joric/nrfmicro/README.md

# nRFMicro

* Project wiki: https://github.com/joric/nrfmicro/wiki
* Latest gerbers: [nrfmicro-main-gerbers.zip](../../releases/latest/download/nrfmicro-main-gerbers.zip)
* iBOM: https://joric.github.io/nrfmicro/
* Note kikit-1.0.0 I use is not compatible with newest Kicad 7. Use [Kicad 6.0.11](https://s3.cern.ch/kicad-downloads/windows/stable/kicad-6.0.11-x86_64.exe) for pull requests.

front|back
--|--
front|back
