joric/nrfmicro/(threads)

Thread 3 (2019-07-09):

Cheaper USB-C connector

BenRoe, 2019-07-09:
Hi,
i followed you project for a while. Right now i collect all the parts.
I already have the pcb's.
I found a cheaper alternative to [your connector](https://lcsc.com/product-detail/USB-Type-C_MC-311D_C136423.html) in the part list.
https://lcsc.com/product-detail/USB-Type-C_Korean-Hroparts-Elec-TYPE-C-31-M-12_C165948.html
I have these connectors here and they fit on the pcb. Connectors too.

joric, 2019-07-09:
I DID point LCSC part to C136423, read my BOM more carefully. Closing.

Closed 2019-07-09.

Thread 4 (2019-07-29):

Capacitors for XTAL

PJE66, 2019-07-29:
Love, Love, Love, Love the project - I'm going to borrow some of the design to integrate into my one hand keyboard which currently uses an ATSAMD21.

Just wondering whether there needs to be two small capacitors (22pF) added to the XTAL to match what Adafruit did.

joric, 2019-07-30:
@PJE66 I was under impression you can skip them and solder the 2-leg resonator (NOT oscillator, oscillator is an active thing with 3-4 legs). They are for the slight frequency correction at inrush and low current. I'm not using external resonator at all, but sometimes it needed if you can't recompile the firmware to use internal RC.  See https://devzone.nordicsemi.com/f/nordic-q-a/40627/zigbee-coordinator-production-configuration-missing-or-invalid/158061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 It works if you solder it directly without those load capacitors.

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

Closed 2019-07-30.

Thread 6 (2019-09-16):

Problem to unlock the nrf chip with Blackmagic

BenRoe, 2019-09-16:
I try to unlock the nrf chip on Linux Debian.
Port is correct (ttyACM0 and ttyACM1 are available).
Wirering should be correct (see picture).
Any idea what the problem could be?

I can't figure out what the problem is.

```bash
arm-none-eabi-gdb --batch -ex "target extended-remote /dev/ttyACM0" -ex "mon swdp_scan" -ex "att 2" -ex "mon erase_mass"
Target voltage: unknown
Available Targets:
No. Att Driver
 1      Nordic nRF52 Access Port
Attaching to Remote target failed
Target does not support this command.
```
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

I also get only one available target in gdb.
```bash
pi@raspberrypi:~/Downloads $ arm-none-eabi-gdb
GNU gdb (7.10-1+9) 7.10
Copyright (C) 2015 Free Software Foundation, Inc.
License GPLv3+: GNU GPL version 3 or later <http://gnu.org/licenses/gpl.html>
This is free software: you are free to change and redistribute it.
There is NO WARRANTY, to the extent permitted by law.  Type "show copying"
and "show warranty" for details.
This GDB was configured as "--host=arm-linux-gnueabihf --target=arm-none-eabi".
Type "show configuration" for configuration details.
For bug reporting instructions, please see:
<http://www.gnu.org/software/gdb/bugs/>.
Find the GDB manual and other documentation resources online at:
<http://www.gnu.org/software/gdb/documentation/>.
For help, type "help".
Type "apropos word" to search for commands related to "word".
(gdb) target extended-remote /dev/ttyACM0
Remote debugging using /dev/ttyACM0
(gdb) set non-stop on
(gdb) mon swdp_scan
Target voltage: unknown
Available Targets:
No. Att Driver
 1      Nordic nRF52 Access Port
(gdb)
```

Lenbok, 2019-09-17:
@BenRoe Cool to see someone else making these.

Before the module is unlocked there is only one target available (the `Nordic nRF52 Access Port` that you see) and that is the one you need to attach to and do the `mon erase` on.

After that, when you connect or do the next `swdp_scan`, you should see two targets available. On my box (old PC hardware running Ubuntu 18.04), I found it a bit troublesome, in that the unlock would kill my USB port.

Here are a couple of pastes from the logs I've been keeping as I go...

Side note: I set up some udev rules so the black magic probe always gets the same name:

```bash
cat <<EOF | sudo tee -a /etc/udev/rules.d/99-blackmagic.rules
# Black Magic Probe
# there are two connections, one for GDB and one for uart debugging
  SUBSYSTEM=="tty", ATTRS{interface}=="Black Magic GDB Server", SYMLINK+="ttyBmpGdb"
  SUBSYSTEM=="tty", ATTRS{interface}=="Black Magic UART Port", SYMLINK+="ttyBmpTarg"
EOF
sudo service udev restart
```
That lets me use `/dev/ttyBmpGdb` with gdb.

On to the unlocking:
```bash
$ arm-none-eabi-gdb --ex "target extended-remote /dev/ttyBmpGdb" --ex "mon swdp_scan"
GNU gdb (GNU Tools for Arm Embedded Processors 7-2018-q3-update) 8.1.0.20180315-git
Copyright (C) 2018 Free Software Foundation, Inc.
License GPLv3+: GNU GPL version 3 or later <http://gnu.org/licenses/gpl.html>
This is free software: you are free to change and redistribute it.
There is NO WARRANTY, to the extent permitted by law.  Type "show copying"
and "show warranty" for details.
This GDB was configured as "--host=x86_64-pc-linux-gnu --target=arm-none-eabi".
Type "show configuration" for configuration details.
For bug reporting instructions, please see:
<http://www.gnu.org/software/gdb/bugs/>.
Find the GDB manual and other documentation resources online at:
<http://www.gnu.org/software/gdb/documentation/>.
For help, type "help".
Type "apropos word" to search for commands related to "word".
Remote debugging using /dev/ttyBmpGdb
Target voltage: unknown
Available Targets:
No. Att Driver
 1      Nordic nRF52 Access Port
(gdb) att 1
Attaching to Remote target
warning: while parsing target description: no element found
warning: Could not load XML target description; ignoring
PC register is not available
(gdb) mon erase_mass
(gdb) detach
Detaching from program: , Remote target
(gdb) quit
```
at which point I had to reboot, then:

```bash
$ arm-none-eabi-gdb --ex "target extended-remote /dev/ttyBmpGdb" --ex "mon swdp_scan"
[...]
Target voltage: unknown
Available Targets:
No. Att Driver
 1      Nordic nRF52 M3/M4
 2      Nordic nRF52 Access Port
(gdb) att 1
Attaching to Remote target
warning: No executable has been specified and target does not support
determining executable automatically.  Try using the "file" command.
0xfffffffe in ?? ()
(gdb) mon erase_mass
erase..
(gdb) load pca10056_bootloader-0.2.11_s140_6.1.1.hex
Loading section .sec1, size 0xb00 lma 0x0
Loading section .sec2, size 0xf000 lma 0x1000
Loading section .sec3, size 0x10000 lma 0x10000
Loading section .sec4, size 0x5de8 lma 0x20000
Loading section .sec5, size 0x70c8 lma 0xf4000
Loading section .sec6, size 0x8 lma 0x10001014
Start address 0x0, load size 182712
Transfer rate: 31 KB/sec, 966 bytes/write.
(gdb) detach
Detaching from program: , Remote target
(gdb) quit
$
```

Then power off BMP; power on BMP; power on USB to nrfmicro; mount the drive that appears. (Note that this was unlocking and flashing the raw module before connecting to the nrfmicro PCB, so I needed the BMP powered on to supply 3.3v to the module -- since yours is assembled you should just be able to connect it directly to the USB).

Now you can copy the precompiled test firmware to check each GPIO can flash a test LED as described on the wiki:

```bash
$ cp blink.uf2 /media/len/NRF52BOOT/
```
After the file copies, the volume will disappear, and the blink code is running, you can then proceed to verifying the pins on the nrfmicro. In all of the ones I soldered I had to wick some more solder to some of the inner pads to get the LED flashing, it's a neat design trick that @joric used there!

I've got my nrfmicros working with the test master/slave keyboard firmware on a corne, and am currently (when I can grab bits of time) updating to get the keymap I normally use working.

joric, 2019-09-17:
Great to see someone else experiences problems with my project! Also take a look at that https://github.com/AndruPol/nrf52832-recover/issues/1 (link from References in the [Software](https://github.com/joric/nrfmicro/wiki/Software) article).

Closed 2019-10-20.

Thread 8 (2019-10-25):

Make 104 keyboard firmware

624245305, 2019-10-25:
Make 104 keyboard firmware, add PIN pin under custom_board.h and pin_assign.h file, make firmware, add some pins and no response.

NRF52 does not have a CAPS/NUM LED pair?

joric, 2019-10-25:
I'm not supposed to decode this.

joric, 2019-10-25:
Assuming that "104" means you're making a 104-key keyboard using my controller, you won't have enough broken out pins. You can solder your own though.
Assuming "CAPS/NUM LED pair" is about indicator leds (there are usually three of those), I'm really not sure, it may be lost somewhere in the nrf52 fork it could need reading through the code. I haven't really used those.

Lenbok, 2019-10-25:
I think you are right about the nrf52 fork losing caps/num indicator support, as it didn't work for me when I tried displaying those led status on the crkbd OLED a few days ago.

Closed 2019-10-25.

Thread 9 (2019-10-29):

Consider to add more firmware information for alternative boards

kllp, 2019-10-29:
To me it's not clear if the nrf52 branch works for the following boards:
Adafruit Feather nRF52840 Express
Particle.io Xenon
Arduino Nano 33 BLE
STM32WB55

How much work is needed for each of them?
If you know please add a note to the wiki page. Thank you!
https://github.com/joric/nrfmicro/wiki/Alternatives#adafruit-feather-nrf52840-express

joric, 2019-10-29:
I have no idea really. That would require buying every board in the list.

Closed 2019-10-29.

Thread 10 (2019-11-12):

Where would I connect a LiPo battery?

skybound, 2019-11-12:
Thank you very much for this.  I ordered some PCBs myself, they should arrive within a few weeks.

I see there's a LiPo charger, but it doesn't look like VBAT is broken out to a pin.  How would I connect a battery?

joric, 2019-11-12:
[https://github.com/joric/nrfmicro/wiki/Hardware](Li-Po battery uses RAW and GND pins)

skybound, 2019-11-12:
I missed that section. Thank you.

Closed 2019-11-12.

Thread 11 (2019-11-13):

Battery life with coin battery?

Na-Cly, 2019-11-13:
Hey just wondering what kind of battery life you see with the coin cell battery. Do you know what it should be for a fully wireless split keyboard
Thanks.

joric, 2019-11-13:
I'd rather use 130 mAh 501230 lipo batteries they fit under promicro. Battery life could vary from 1-2 weeks to a few months but it doesn't really matter because batteries are rechargeable.

Lenbok, 2019-11-13:
Nice to see that battery recommendation. I am using these https://www.aliexpress.com/item/32981806740.html (they are quite long).

I don't currently have a battery estimate (I'm still trying to find out why I can't pair with my linux box, when it pairs to MacOS and Android just fine, could be my BT dongle), but a couple of things I've noted so far:

* With the current firmware the blue nrfmicro LED is illuminated essentially all the time, so we probably need to switch that off in software for battery conservation.
* I'm not sure how to monitor battery voltage on the slave side (for the master side there is a binding to echo it out as a string of keypresses, and I've also got it displaying on the oled, but I only have one oled connected)

Closed 2019-11-13.

Thread 12 (2019-11-13):

Licensing

Na-Cly, 2019-11-13:
Hey I see your pcb uses the Unlicense, but do you know if there's any restrictions when building this in regards to reselling? I'm planning on making a small batch and wanted to know if there was anything you knew of that would restrict resale.

joric, 2019-11-13:
It should be fine. Adafruit bootloader is MIT licensed so it should be ok to sell preflashed devices as well. But don't take my word for it, do your own research, I can't really help for that matter.

Closed 2019-11-13.

Thread 13 (2019-12-08):

coin cell battery vs lipo

fi0, 2019-12-08:
If I use a coin cell battery like CR2032 (not rechargeable) instead of lipo, how should I correctly connect it to the board? Thank you!

joric, 2019-12-08:
I haven't really though that through ) Better buy a lipo cell or a chargeable LIR2032 they're cheap. You can connect it to RAW/GND but there are no solder jumpers to disconnect it from the charger. I think you can just desolder MCP73831 that feeds 4.2V to the battery so the battery won't explode and you will be good.

fi0, 2019-12-08:
Thank you @joric, I'll go with your first advice :)

Closed 2019-12-08.

Thread 14 (2019-12-16):

Reciever option

haywirephoenix, 2019-12-16:
Would it be straight forward to switch to proprietary 2.4ghz + receiver approach? Pros would be increased battery life, lower latency, using keyboard in bios and usb wake from sleep.

joric, 2019-12-16:
This is not planned, I don't like receivers.

haywirephoenix, 2019-12-16:
It seems to be the choice for companies like Razer, Logitech, Microsoft, Kensington. There must be a reason for that. Can I ask why you don't like them? My question was if it was possible with some changes to the firmware.

I'm new to this, recently ordered everything for Nrfmicro and looking forward to the build. Thanks for your work on this btw!

joric, 2019-12-16:
I use exclusively laptops since about 2006 and I don't have much USB ports but there's always bluetooth , so receivers are not my jam. I made https://github.com/joric/bluetosis specially to get rid of receivers and I'm not planning to bring them back.

Closed 2019-12-16.

Thread 15 (2020-01-01):

Question about jumpers

Na-Cly, 2020-01-01:
Hey I noticed there's a few jumper pads. I can't seem to find on the wiki where it talks about what they are used for.

Thanks in advance.

joric, 2020-01-01:
Promicros on corne are usually flipped, if you got corne with hotswap sockets you can use those jumpers to keep antenna up. top 4 rows of pins can be flipped by those jumpers, bottom 8 rows of pins could be just remapped, as here (build with CFLAGS += -DFLIPPED_NRFMICRO):
https://github.com/joric/qmk/blob/nrf52-jorne/keyboards/jorne_ble/board/custom_board.h

Closed 2020-01-01.

Thread 16 (2020-01-21):

Pull USB-C pads farther down for handsoldering

skorokithakis, 2020-01-21:
This board is great, but handsoldering the USB-C module is rather harder than it should be because the pads are sitting flush with the connector pins. If you pull the pads a bit farther down, there will be enough space to handsolder comfortably.

I only managed to do it when I cut the top throughholes a bit and pushed the connector higher up to give it some space.

joric, 2020-01-21:
Yeah I'll account for it. The whole USB-C footprint needs rethinking because the front of the connector sits flush the pcb, it should be out for about 1mm. Haven't had so many problems with soldering though, just used more flux :)

Closed 2020-01-21.

Thread 17 (2020-01-25):

Led polarity

Na-Cly, 2020-01-25:
Is there an easy way to tell which way the LEDs lay for polarity? Its hard to tell from the picture, but I notice on the bottom I see a shape that looks like you can determine cathode from anonde.

joric, 2020-01-25:
what the hell. it's a square bracket on the pcb and a green stripe on the led. it's a STANDARD smd led footprint nobody redraws that from scratch

Na-Cly, 2020-01-25:
Never used smd LEDs this small and the hardware page shows the led already soldered. Thanks for getting back to me so quickly.

Closed 2020-01-25.

Thread 18 (2020-02-09):

The reset button to boot to the UF2 Mass Storage device.

luantty2, 2020-02-09:
Hi, I'm trying the nrfmicro but I noticed that there isn't a reset button on board, which might be needed in this process:
>After flashing the bootloader press reset button twice within 500ms interval to boot to the UF2 Mass Storage device. You have to convert standard .hex firmware to the UF2 format, using uf2conv.py.

Is that mean I need to create a button on my keyboard PCB? If it does,  which pins should  I connect to the button? Is that *GND* and *RESET* pin(P0.18)?
Also, in file *custom_board.h*,  it says:
```
#define RESET_PIN GPIO(1,18)
```
I found that the reset pin of nrf52840 should be P0.18, does this matter?

joric, 2020-02-09:
Keyboards usually have reset buttons connected to the promicro reset pin. To reset the keyboard programmatically see https://github.com/joric/qmk/blob/nrf52-jian/keyboards/jian_ble/keymaps/default/keymap.c#L141 (it's a little bit complicated).

joric, 2020-02-09:
Regarding 1.18 yeah I guess it's a typo, should be 0.18. But it's not used anywhere, probably it can be remapped from reset to something else but I'm not really sure. It's connected to the promicro reset pin.

vexchow, 2020-05-07:
Hi Joric,
Same question here.
I load the pca10056_bootloader-0.2.11_s140_6.1.1.hex or nrf51822_xxac.hex or s130_nrf51_2hex.
And then connect reset and GND, But nothing happens.
[https://imgur.com/a/fniLNi7](url)

I spend 3 days to try, can you please give some suggestion?
Thanks a lot.

joric, 2020-05-07:
it's double reset. also check solder jumpers.

Closed 2020-05-09.

Thread 20 (2020-03-02):

Group Buy Plans

NellyWhadsDev, 2020-03-02:
Heyo,

Wondering if you have any plans to run a group buy for this any time soon. Also, the build log is awesome - do you have something similar for ideas/planned changes/what still needs to be done (even if just for personal satisfaction)?

Awesome work; hoping to have these driving my first crkbd and/or ergodash boards.

joric, 2020-03-02:
None. No plans. Regarding ideas, see midmount and devel branches, PCBs are yet untested (still waiting for them, turnarounds are like 2 months considering sourcing all the components and sometimes it gets lost in transit). I got rid of voltage regulator, there's an internal one, added power mosfet and a better battery divider (800K/2M) to minimize leaks but it costed a physical switch and reversability in favor of ultra low profile (~2.5mm if you remove shielding).

Closed 2020-03-02.

Thread 21 (2020-03-29):

Lipo battery not charging

luantty2, 2020-03-29:
The voltage of battery does not change after charging for 1 hour, my multimeter always says the voltage of battery is 3.90V, is there any way to detect if the battery charging circuit is working?
And I noticed that the voltage of my 'VBUS' is 5.16V, which is a little bit higher than the protection circuit on the battery(they specified 4.2V-5V), could this be the problem of preventing the battery from charging?

joric, 2020-03-29:
Charging voltage is always 4.2V, VBUS is always 5V. Battery should charge no matter what, if the voltage is right.

luantty2, 2020-03-29:
Okay, it's charging now, caused by my bad soldering, thanks.

Closed 2020-03-29.

Thread 23 (2020-04-27):

Issue: Flashing Bootloader for Holyiot nrf52840

marhalloweenvt, 2020-04-27:
Hello joric,

I have followed your work for a while and they are really amazing.
Recently, i decided to design a board using nrf52840. So i bought some Holyiot nrf52840 module from China and followed your schematic. Currently, i am using stlink-v2 and Msys32 to flash this module. I can't unlock nor flash bootloader for this module. Please have look at below log for flashing bootloader:

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

And when i tried to unlock this module, it gives me this mess:

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

Could you please give me some advice what I should do?

Thank you,

joric, 2020-04-27:
I've been told openocd just works without unlocking. Haven't really tried. The command was openocd -f interface/stlink.cfg -f target/nrf52.cfg -c "gdb_flash_program enable" -c "gdb_breakpoint_override hard" -c "init" -c "reset halt" -c "flash write_image erase ./adafruitnrf52.hex" hope that helps.

Closed 2020-04-27.

Thread 24 (2020-05-14):

Parts list for v1.2

tlrogers-lap, 2020-05-14:
Joric, I just purchased 4 v1.2 alpha boards and am interested in building them. It does not look like the parts list BOM here [https://github.com/joric/nrfmicro/wiki/Hardware](https://github.com/joric/nrfmicro/wiki/Hardware) would align to the v1.2 alpha board. Might I get a parts list for the alpha?

joric, 2020-05-14:
You should've waited for the release ) There a new 1.2 pre-release that's different (no AP2112K at all).
Alphas should work though. You'd need a few parts, search for them on aliexpress or something:
* a midmount USB-C connector
* 10 uH inductor (0603 package)
* MCP73811 (probably will also work with an old MCP 73821, just use software pulldown for the PROG pin)
I guess that's about it.

tlrogers-lap, 2020-05-14:
Thanks a lot. Just found your github today and have been reading heavily on it as I am working on a keyboard and would like to leverage your amazing work.

Will the high voltage pre-release version still be running at 3.7 volts or was the high voltage reference going to a 5 volt version. Did not find enough info on the pre-release since you just posted it minutes ago ;^)

Trace

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

tlrogers-lap, 2020-05-14:
Will review the Kicad now and validate. May wait to build until you reach release. Thanks again for all the work!

joric, 2020-05-14:
High voltage refers to an internal nRF52840 LDO (1.8V internal current). 1.2 alpha uses internal LDO in conjunction with external LDO, 1.2 pre-release uses internal LDO and unfiltered battery/USB output, because, what the hell, all those pro micro-based keyboards are 5V and feeding 3.3V via TRRS is kind of questionnable (you could use 5V LDO there though).

Closed 2020-05-14.

Thread 25 (2020-06-07):

Help with debuging.

ilukinov, 2020-06-07:
He, Joric,
Thanks for puttign so much time into this project.
I'm building my own keyboard and wanted to try this nrf52 qmk  firmware on a dongle before I order pcb's.

I have [this](https://www.nordicsemi.com/Software-and-tools/Development-Kits/nRF52840-Dongle) dongle from Nordic and can't figure out how to make it work with nrf52 qmk firmware, can you help me on how do I debug this firmware.

**What I already managed to do:**
1. Unlocked and flashed bootloader (pca10056_bootloader-0.2.11_s140_6.1.1.hex)
2. Confirmed that I can upload uf2 firmware via usb (tried circuitpython, blinked led on a board)
3. Tried to flash your [modified](https://github.com/ilukinov/qmk/tree/nrf52-jorne/keyboards/keyt_ble)(changed pins to mine) jorne firmware(master half), but nothing happens, no new usb device appears, no keys send, no debug port, no bluetooth device.

Can you please take a look at my code and, maybe you will spot some obviuos thing that I did wrong or need to change?

Thanks

joric, 2020-06-08:
I can't help really, I just can't. Maybe there is a boot loop or something, maybe keys are always pressed because pins are soldered to LEDs instead of input, I don't know really.

Closed 2020-06-08.

Thread 27 (2020-09-18):

I used the ZMK firmware ext_ VCC does not have the correct output

a826889260, 2020-09-18:
I used the ZMK firmware ext_ VCC does not have the correct output， When I'm not connected to RGB, the voltage is 3.3V. But as soon as I connect the RGB voltage to 2. + V。
is power pin problem？

joric, 2020-09-18:
yes if it's uninitialized it leaks through the floating gate

a826889260, 2020-09-18:
#if CONFIG_BOARD_NRFMICRO_13
    struct device *p0 = device_get_binding("GPIO_0");
    // enable EXT_VCC (use 0 for nRFMicro 1.3, use 1 for nRFMicro 1.1)
    gpio_pin_configure(p1, 9, GPIO_OUTPUT);
    gpio_pin_set(p1, 9, 0);
i try it
but  it didn't seem to work

joric, 2020-09-18:
are you just randomly mashing keys
it's pin P1.09
so it should be GPIO_1

Lenbok, 2020-09-18:
Is nrfmicro directly supported in ZMK master, or do you need to build off joric's personal fork?

Lenbok, 2020-09-18:
Nice, I just looked and nrfmicro 1.1 onwards are in there now, (although I'm still on 0.03 boards until my 1.3 PCBs arrive.

a826889260, 2020-09-19:
There's more ahead
 struct device *p1 = device_get_binding("GPIO_1");
But still no effect

joric, 2020-09-19:
maybe bad soldering. I got zmk working with stable voltage on the oled and leds. see wiki

a826889260, 2020-09-19:
I replaced the a03407 and found the job

Closed 2020-09-18.

Thread 31 (2020-10-05):

E73 on the other side on rev1.3

enikesha, 2020-10-05:
Am I getting this right that E73 has moved onto other side of pcb on rev1.3? If that's the case, what is the best way to use it on jorne? Should it be socketed same way as ProMicro, bottom side up with E73 between pcbs? I'm not sure the LiPo will fit with the shield in place.
Or it could be possible to use other column for sockets? Not sure that TRRS could be used as is. And OLED jumper-pads should be soldered on the backside?

joric, 2020-10-05:
Yes it's supposed to be flipped antenna down. It's also 2x thinner. Allows oled screens to be at the same height as with pro micro. It's a DROP IN pro micro replacement so please do not modify the host keyboard in any way.

Closed 2020-10-05.

Thread 35 (2020-10-25):

U2 capacitor to ground

pseudobacon, 2020-10-25:
Hi in the release notes for 1.4 it says that a capacitor was added between the 3v3 regulator and ground.
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

But this seems to be missing from the schematic, as well as the PCB, as well as the BOM? I only noticed because I got 1.3 printed, and shortly after the boards arrived at my forwarding warehouse 1.4 was released haha.

joric, 2020-10-25:
There's no space for capacitor it's been replaced with XTAL. I'll fix the documentation.

Closed 2020-10-25.

Thread 36 (2020-11-15):

BOM for v1.4?

pluskid, 2020-11-15:
Can we have a BOM for v1.4 in the same way as v1.3? I know that most of the parts are similar as v1.3, but I think copying over the old information and making necessary is very useful for beginners, esp. someone who has not been following along since the earlier versions. In particular, I was trying to follow using the v1.3 BOM and only half way through did I realize the component IDs are not one-to-one mapped. I have to cross check with the schematic to figure out which one is which for some of the components.

A few other minor suggestions: I think this figure from v1.3 is very helpful:

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

Can we have a similar one for v1.4 and future versions? It does not need to be based on 3D rendered images, I think annotation on real photo works equally well.

The symbol on the silkscreen for the diode is not standard? -- or maybe I'm just not very familiar with the conventions. Maybe it helps to mention a word in each release page how to read the polarity?

Thanks again for sharing such awesome project!

joric, 2020-11-16:
I don't have 1.4 pcbs and assembled boards it's in the status article, so maybe you could do it.

joric, 2020-11-16:
All done. Closing.

pluskid, 2020-11-16:
Thanks a lot for the updates! I'm happy to contribute, but I'm quite new to this and I'm not even sure if my first assembled board is working or not since I don't have something to burn the bootloader yet. It's great that you updated them!

pluskid, 2020-12-18:
The updated wiki is very helpful. Here are a few minor suggestions:

1. The BOM table list U3 and U4, I believe it should be U2 and U3?
2. The wiki says "You may improve the board using more expensive BAT60B and XC6220. See Components article.". As a beginner, I think the original instructions is more helpful. i.e. BAT60B schottky diode can replace 1N5819, XC6220B331MR-G can replace AP2112K, etc.

Thanks again!

joric, 2020-12-18:
fxd

joric, 2021-10-03:
New link https://github.com/joric/nrfmicro/wiki/BOM#nrfmicro-14

Closed 2020-11-16.

Thread 37 (2021-01-30):

Computer not detecting nrfMicro 1.1 over USB, after I was able to flash bootloader using blackmagic and bluepill

harshitgoel96, 2021-01-30:
hi. i was able to flash the nrf micro using bluepill. there was warning, but no error. after flashing when i connect the micro to pc using micro usb, it is not getting detected by the pc. nor there is any led activity on the board.

harshitgoel96, 2021-01-30:
I am getting Vcc reading of around 3v over usb, so vcc, and GND are connected properly. could it be issue with data line under pads?

joric, 2021-01-30:
Check soldering or something. I don't have an universal solution for that. Check usb connector (it often gets shorted), and USB data (it's on the outer pads).

YHRen, 2021-01-30:
@harshitgoel96 can you direct me to how to flash the nrf? I have v1.1 soldered, but not sure how to flash it. Thank you.

joric, 2021-05-29:
@YHRen what the hell man. Did you miss the entire wiki https://github.com/joric/nrfmicro/wiki/Bootloader

Closed 2021-01-30.

Thread 38 (2021-02-19):

Heating of nrfmicro

jrhrsmit, 2021-02-19:
In wake of your [reply](https://github.com/zmkfirmware/zmk/pull/669#issuecomment-780250351) on a PR I submitted on ZMK, I went on investigation.
It took me a while to understand what you were talking about (hence the confusing replies), but I think I understand your issue now, so I took the liberty of checking out your nrfmicro schematic.
I assume you were talking about D1 in the [schematic of the nrfmicro](https://github.com/joric/nrfmicro/releases/download/1.1/nrfmicro-1.1-schematic.pdf).
It seems D1 uses a SOD-123 package, and according to [this datasheet](https://datasheet.lcsc.com/szlcsc/1907060333_LGE-1N5819W_C402219.pdf) the 1N5819 has a forward voltage of ~0.4V at 0.6A (max LDO current, but 28 SK6812s may draw more than that), and with a typical thermal resistance of 250 degC/W, this results in a package temperature rise of 60 degC.
Thus it seems that it is indeed the cause of the heating problem you experienced.
The solution would be using a diode with a lower forward voltage and/or lower thermal resistance.

joric, 2021-02-19:
1) D1 is SOD-323 on all the boards except ancient 1.1 ones, not SOD-123.
2) Wasn't 1N5819 issue for me. BAT60 heats up too despite it's rated 3A.

I've covered it here https://github.com/joric/nrfmicro/wiki/RGB#diode-overheating-issue but I'm really not sure which diode could solve the problem. Seems like pro micros don't have this issue and their power circuit is very similar.

jrhrsmit, 2021-02-20:
Ah forgive my shortsightedness.
It indeed seems the BAT60 is the best JLC has to offer for SOD323 packages. However, I just checked out the layout, and it seems the diode has no copper pour/plane to dissipate power to (which can make a significant difference).
You could consider using a 4-layer PCB, using the middle layers as ground and VBUS (and connecting the VBUS pin with vias to that layer).
Another option could be increasing the copper area by using copper pours attached to the pads of the diode on the top layer. Other traces and vias should then be moved away as far as possible to increase the copper area. There are some whitepapers available on this subject.

Anyway, as I see that you've explored this problem already, I'll just close this issue.

Closed 2021-02-20.

Thread 39 (2021-04-15):

Question: nRFMicro 1.1 LEDs D2/D3 orientation

Raskilas, 2021-04-15:
Hi, my question might be silly and outdated, but which orientation should I use for LEDs **D2** and **D3** on **nRFMicro 1.1** board?

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

joric, 2021-04-16:
Are you kidding me. It's all there in the picture. Front has matching green on my picture and on yours. Bracket on the PCB is CATHODE (+), so put traces of the green shit there, don't look at the back, back is different from the front. Also See https://lighthouseleds.com/blog/polarity-guide-of-0402-0603-0805-1206-and-most-all-smd-leds.html

Raskilas, 2021-04-16:
> Are you kidding me. It's all there in the picture. Front has matching green on my picture and on yours. I only look at the front. Don't look at the back, back is different. Also see https://lighthouseleds.com/blog/polarity-guide-of-0402-0603-0805-1206-and-most-all-smd-leds.html Mind that LEDs don't have to blink by default, adafruit bootloader knows nothing about pin 1.10. The easiest way to check leds is probably Circuitpython, https://github.com/joric/nrfmicro/wiki/Circuitpython

Sorry for confusion, I meant where there is Cathode and Anode on board. It's NOT question about TOP/BOTTON orientation, it is about "Cathod on TOP of D2 or on BOTTOM and cathod on TOP of D3 or on BOTTOM". I just attached front/back pictures in case if someone in future won't be able to check back side of his/her LED.

joric, 2021-04-16:
There are standard footpints. Key (bracket) on the silk is Cathode (minus). It usually goes to ground via load resistor.

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

Raskilas, 2021-04-16:
Thanks!

Closed 2021-04-16.

Thread 40 (2021-04-27):

[QA] Can I modify the width to 20mm for JLCPCB SMT assembly?

donus3, 2021-04-27:
I just wondering can I add more width to the pcb each side by 1mm? Would It affect to anything? The reason is that JLCPCB has a choice to let them do SMT assembly. But the min required size is 20 x 20. while the v1.4 size is 18 x 34.

Thank you

King-Icewind, 2021-04-27:
That will be fine.

joric, 2021-04-27:
yea or just add a couple of ears as in https://github.com/joric/nrfmicro/wiki/PCBA. you didn't read wiki did you

Closed 2021-04-27.

Thread 41 (2021-04-27):

nrfMicro 1.1 doesn't detects via USB, possible duplication of #37

Raskilas, 2021-04-27:
Hi, it is me again). It have a similiar symptoms, but I gathered more details, I can augment #37 if it necessary.
I've got Bluepill from Aliexpress and it have **CKS32F103C8T6** chip. I've used UART module with [STM32 Flash loader demonstrator](https://www.st.com/en/development-tools/flasher-stm32.html) to upgrade it.

I've checked nrfMicro according to the method described in wiki [Testing](https://github.com/joric/nrfmicro/wiki/Soldering#testing) and I've got 3.3V on VCC, 4.2V between B- and B+, ~5.2V on USB-C power pin, and have voltage drop 0.6-1.1V on almost all pads. Voltage drop also exist 0.6-1.1V between B- and E73 backpads and soldered components (except cases when some of them have direct/short connection like antenna or E73 shield), but couple resistors shows, I think, off scale values (may be it is the cause). Red LED is glowing when I plug nrfMicro to USB port. After soldering nrfMicro doesn't recognizable via USB - is it correct?

I tried to flash E73 on linux and here is what I have:
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

1) So is there any advice of what I can check additionally or what should I do?
2) May be I should find Bluepill with STM... chip instead of CKS...?
3) Do you have a some reference map, so I could check drop of voltage between all solder contacts/fields?
4) Is unlocking and flashing of E73 completed successfully?

joric, 2021-04-28:
* New unflashed chip does not work with USB, because well, there's no firmware.
* Bootloader has been flashed correctly, according to the Big Picture, so normally it pops up USB drive right away.
* I don't have methodology for checking out badly soldered USB connector. Just check that all USB pins are soldered. That includes VBUS, CC1, CC2, and D+ D- pins, they all should go where they belong and should not be shorted to each other.

Closed 2021-04-28.

Thread 46 (2021-08-31):

CircuitPython Support for 2G4M08S1E - nRF52833-based?

ChangcongWang, 2021-08-31:
I realize nRF52833 have half flash that couldn't use CircuitPython on it. Can I freeze modules to make the Circuitpython firmware smaller to solve this problem? What are the other reasons why circuitpython cannot be used on nrf52833?

joric, 2021-09-01:
haven't tried. yea it's the size.

Closed 2021-09-01.

Thread 51 (2021-12-09):

1.8v in high voltage mode

ImMrMa, 2021-12-09:
Hi joric,
I follow your wiki made a board by myself, when use your bootloader, I found that in high voltage mode it can only output a signal of 1.8v. What should I do to output a 3.3v signal ?

joric, 2021-12-09:
https://github.com/joric/nrfmicro/wiki/Archive#power-switch-issues

ImMrMa, 2021-12-11:
Ok, So I'm using your nrf52 QMK branch, should I insert the code in QMK codebase somewhere is ok?

joric, 2021-12-11:
Unless you have a few years of spare time I don't recommend using wireless QMK, there are no maintainers. Try ZMK first.

ImMrMa, 2021-12-11:
Okay, thanks for your suggestion, although I have been trying on qmk for a long time, I will try zmk

ImMrMa, 2021-12-19:
Thanks again for the suggestion! ZMK has solved a lot of the problems I had on QMK. It was really cool!

ImMrMa, 2021-12-19:
By the way, I would like to refer mikoto as the first PCBA version, do you have any suggestion on the nrf52840 PCBA?

joric, 2021-12-19:
I don't give a fuck I know I was first.

Closed 2021-12-09.

Thread 54 (2022-02-07):

zephyr port?

ntn888, 2022-02-07:
does the mainline zephyr have a port for this board?

joric, 2022-02-07:
ZMK does. Zephyr doesn't https://docs.zephyrproject.org/2.6.0/boards/index.html

Closed 2022-02-07.

Thread 56 (2022-03-20):

zephyr support

ntn888, 2022-03-20:
this is an excellent project! finally an affordable lowpower IOT board. (i believe it's 30usd/5bunch on PCBway fully assembled)

are there any plans of getting this board upstream on zephyr rtos? i believe this would make it to the next level! also bring up some exposure...

joric, 2022-03-20:
There's no Zephyr but there's ZMK (use nRFMicro 1.3 define). I don't think it can be mass produced (pads are too small and courtyards are too close), it's a DIY board, handsoldering only.

ntn888, 2022-03-20:
i see. thanks for the attention!

Closed 2022-03-20.

Thread 57 (2022-03-31):

Firmware starts only after openocd init. How to factory reset nrf52840?

yejianfengblue, 2022-03-31:
I'm building the nrfmicro using an ebyte E73-2G4M08S1C nrf52840. My programmer is cmsis dap link. Openocd verson is 0.11.0.

I built two controllers successfully and they run firmware (blink and zmk) well. Another controller (the third one) which was built in the same way, but after I reconnect power, the nrfmicro controller starts firmware only after I connect cmsis dap link and run command
`openocd -d2 -f interface/cmsis-dap.cfg -f target/nrf52.cfg -c init -c exit`

I guess this is a software issue rather than soldering issue or hardware damage. I tried desoldering the e73 module and use a new PCB, and re-flash the bootloader but it does't help.

Is there a way to factory reset the nrf52840? So that I flash again from the beginning?

Below are what I did and how the controller behaves

1. Unlock is fine
```
openocd -d2 -f interface/cmsis-dap.cfg -f target/nrf52.cfg -c "init" -c "nrf52.dap apreg 1 0x04 0x01" -c "exit"

############## unlock output omitted

openocd -d2 -f interface/cmsis-dap.cfg -f target/nrf52.cfg -c "init" -c "nrf52.dap apreg 1 0x04" -c "exit"       

Open On-Chip Debugger 0.11.0
Licensed under GNU GPL v2
For bug reports, read
        http://openocd.org/doc/doxygen/bugs.html
debug_level: 2

Info : auto-selecting first available session transport "swd". To override use 'transport select <transport>'.
Info : CMSIS-DAP: SWD  Supported
Info : CMSIS-DAP: FW Version = 2.0.0
Info : CMSIS-DAP: Serial# = 205526554555
Info : CMSIS-DAP: Interface Initialised (SWD)
Info : SWCLK/TCK = 1 SWDIO/TMS = 1 TDI = 0 TDO = 0 nTRST = 0 nRESET = 1
Info : CMSIS-DAP: Interface ready
Info : clock speed 1000 kHz
Info : SWD DPIDR 0x2ba01477
Info : nrf52.cpu: hardware has 6 breakpoints, 4 watchpoints
Info : starting gdb server for nrf52.cpu on 3333
Info : Listening on port 3333 for gdb connections
0x00000001
```

2. Flash bootloader [pca10056_bootloader-0.5.0-dirty_s140_6.1.1.hex](https://github.com/joric/nrfmicro/releases/download/1.4/pca10056_bootloader-0.5.0-dirty_s140_6.1.1.hex) successfully
```
openocd -d2 -c 'set WORKAREASIZE 0;' -f interface/cmsis-dap.cfg -f target/nrf52.cfg -c init -c "program ./pca10056_bootloader-0.5.0-dirty_s140_6.1.1.hex verify reset exit"

Open On-Chip Debugger 0.11.0
Licensed under GNU GPL v2
For bug reports, read
	http://openocd.org/doc/doxygen/bugs.html
debug_level: 2
Info : auto-selecting first available session transport "swd". To override use 'transport select <transport>'.
Info : CMSIS-DAP: SWD  Supported
Info : CMSIS-DAP: FW Version = 2.0.0
Info : CMSIS-DAP: Serial# = 205526554555
Info : CMSIS-DAP: Interface Initialised (SWD)
Info : SWCLK/TCK = 1 SWDIO/TMS = 1 TDI = 0 TDO = 0 nTRST = 0 nRESET = 1
Info : CMSIS-DAP: Interface ready
Info : clock speed 1000 kHz
Info : SWD DPIDR 0x2ba01477
Info : nrf52.cpu: hardware has 6 breakpoints, 4 watchpoints
Error: nrf52.cpu -- clearing lockup after double fault
Polling target nrf52.cpu failed, trying to reexamine
Info : nrf52.cpu: hardware has 6 breakpoints, 4 watchpoints
Info : starting gdb server for nrf52.cpu on 3333
Info : Listening on port 3333 for gdb connections
target halted due to debug-request, current mode: Thread
xPSR: 0x01000000 pc: 0xfffffffe msp: 0xfffffffc
** Programming Started **
Info : nRF52840-xxAA(build code: D0) 1024kB Flash, 256kB RAM
Info : Padding image section 0 at 0x00000b00 with 1280 bytes
Info : Flash write discontinued at 0x00025de8, next section at 0x000f4000
Warn : Adding extra erase range, 0x00025de8 .. 0x00025fff
Warn : not enough working area available(requested 34)
Warn : no working area available, falling back to slow memory writes
Info : Padding image section 2 at 0x000fc124 with 5852 bytes
Warn : Adding extra erase range, 0x000fd858 .. 0x000fdfff
Warn : not enough working area available(requested 34)
Warn : no working area available, falling back to slow memory writes
Warn : Adding extra erase range, 0x10001000 .. 0x10001013
Warn : Adding extra erase range, 0x1000101c .. 0x10001fff
Warn : not enough working area available(requested 34)
Warn : no working area available, falling back to slow memory writes
** Programming Finished **
** Verify Started **
Warn : not enough working area available(requested 52)
Warn : not enough working area available(requested 52)
Warn : not enough working area available(requested 52)
Warn : not enough working area available(requested 52)
Warn : not enough working area available(requested 52)
** Verified OK **
** Resetting Target **
shutdown command invoked
```

3. Flash the blink.uf2 or zmk firmware
4. The blink or zmk works as expected, until power is disconnected
5. disconnect USB power and reconnect
6. The blink or zmk firware doesn't start
7. Connect cmsis dap link and run command `openocd -d2 -f interface/cmsis-dap.cfg -f target/nrf52.cfg -c init -c exit`
8. The blink or zmk works as expected, until power is disconnected

yejianfengblue, 2022-03-31:
understand. thank you for reply anyway

Closed 2022-03-31.

Thread 58 (2022-05-21):

Any plan on embedding the nrf52840 directly on the board?

Miigon, 2022-05-21:
It seems like JLCPCB now has NRF52840-QIAA-R in stock. If we embed the nrf52840 directly on the board, the whole board can be assembled using JPCPCB SMT soldering service, with no hand-soldering required.
It's also probably cheaper to do it this way since we don't have to purchase the components separately

joric, 2022-05-21:
https://github.com/joric/nrfmicro/wiki/PCBA

Closed 2022-05-21.

Thread 59 (2022-05-26):

Black magic probe does not show up in COM ports

JiaGengChang, 2022-05-26:
Hi Joric,

I flashed black magic firmware into bluepill using ST-LINK V2 as the UART-to-USB method did not work for me (maybe because of the BOOT0 resistor issue you linked).

Now, black magic ports show up under "libusb-win32 devices" on windows 10 device manager, instead of showing up under Ports (COM & LPT).

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

I suspect it is because of this reason that the remaining instructions to unlock and flash do not work (error is that COM5 is not recognized).

The Ports (COM & LPT) dropdown only appears when I click "View -> Show hidden devices", and it is the following
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

In this case, is there a way to locate this Black Magic GDB Server?

JiaGengChang, 2022-05-26:
Hi Joric,

As an update, I have also managed to flash black magic firmware into bluepill using UART and the official demonstrator GUI from STM.

However, the issue that the black magic probe does not show up under Ports (COM and LPT) in Device Manager persists. It still shows up under "libusb-win32 devices", and so I do not know what its address.

JiaGengChang, 2022-05-26:
I managed to solve this problem.

First, my version of zadig (2.0) was not the latest version (version 2.7). So I switched to that.

Using zadig 2.7, I upgraded/downgraded both Black Magic GDB Server and Black Magic UART port to "USB Serial (CDC)".

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

Two COM ports instantly appeared in windows 10 Device Manager.

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

Selecting anything other than "USB Serial (CDC)", including the "libusb-win32" that is recommended in the wiki bootloader section, prevents the ports from being shown in device manager.

Timception, 2022-10-25:
I managed to get to the same place you did. After that, I cannot get the bluepill blackmagic to flash the nrfmicro. Been trying for weeks. Im not a pro and the explanation and clip are too funny and skip so many things for noobs like me. I bought j-link, st-link, everything. None work after following the documentation. Help needed badly.

Sweet-tooth-man, 2023-02-15:
> Мне удалось добраться до того же места, что и вы. После этого я не могу заставить bluepill blackmagic прошить nrfmicro. Пытался неделями. Я не профессионал, и объяснение и клип слишком забавны и пропускают так много вещей для нубов, таких как я. Я купил j-link, st-link, все. Ни один из них не работает после выполнения документации. Помощь нужна очень.

did you manage to solve the problem?

Closed 2022-05-26.

Thread 60 (2022-06-28):

Need help!: problem flashing the bootloader

lebbtheoriginal, 2022-06-28:
Hi, first of all thanks for the work you put in. But i have met a problem that i can't seem to solve:

board nrfMicro 1.4
When i tried flashing the chip with a bluepill flashed with bmp they output this error:

Target voltage: ABSENT!
Exception: SWDP invalid ACK
SW-DP scan failed!
Attaching to Remote target failed
Target does not support this command.

i thought that i solder something wrong, after a few weeks of frustrations and google searching, even hooking up a pull up resistor doesn't seems to fix the problem, even ordering another bluepill to test output the same error, and when i tried an st-link flash with cmis-dap patch they output this:

Open On-Chip Debugger 0.11.0
Licensed under GNU GPL v2
For bug reports, read
	http://openocd.org/doc/doxygen/bugs.html
debug_level: 2

swd
Warn : Using CMSIS-DAPv2 interface 1 with wrong class 10 subclass 0 or protocol 0
Info : Using CMSIS-DAPv2 interface with VID:PID=0xc251:0xf001, serial=0001A0000000
Warn : could not claim interface: Resource busy
Error: error writing data: Input/Output Error
Error: CMSIS-DAP command CMD_INFO failed.

the kernel log:
[ 5017.882236] usb 1-7.4: Product: CMSIS-DAP
[ 5017.882237] usb 1-7.4: Manufacturer: X893 ARM
[ 5017.882239] usb 1-7.4: SerialNumber: 0001A0000000
[ 5017.907217] cdc_acm 1-7.4:1.0: ttyACM0: USB ACM device
[ 5017.907894] hid-generic 0003:C251:F001.0013: hiddev3,hidraw7: USB HID v1.00 Device [X893 ARM CMSIS-DAP] on usb-0000:02:00.0-7.4/input2
[ 5254.884960] usb 1-7.4: usbfs: process 13627 (openocd) did not claim interface 1 before use
[ 5307.286692] usb 1-7.4: usbfs: process 13957 (openocd) did not claim interface 1 before use

this seems like openocd cant claims the interfaces for cmisdap,is theres anyway else to flashing the nrfMicro? i might even try the j-link but i dont think it will be better

joric, 2022-06-28:
I don't know really =( try flashing a standalone module maybe it's soldering.

Closed 2022-07-14.

Thread 61 (2022-08-26):

Unrecognized Device Blue Pill to Blackmagic

drakumus, 2022-08-26:
Followed instructions to download blackmagic to blue pill:

- Hook up an UART adapter to Bluepill (A9 - RX pin, A10 - TX pin).
- Set Bluepill jumpers to the bootloader mode (BOOT0 jumper=1, BOOT1 jumper=0).
- Plug in UART adapter to the computer. Run "STM32 Flash loader demonstrator".
- Download to device blackmagic_dfu.bin at offset 0x8000000 with "Global Erase" option. < verified
- Download to device blackmagic.bin at offset 0x8002000 with "Erase necessary pages" option. < verified
- Put Bluepill jumpers back to the operational mode (BOOT0 jumper=0, BOOT1 jumper=0).
- Using Zadig after that to attempt to install libusb-win32 fails. < FAILS

When plugging back in the Bluepill windows no longer recognizes the device.
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
Attempting to install libusb-win32 drivers to the device with zadig fails as well.
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
This happened on 2 blue-pills.

Plugging in the blue-pills before attempting this process showed up on windows as STM32X device and the fact that UART was successful tells me it's unlikely the Dataline resistor is at fault here. Not sure what to do at this point

joric, 2022-08-26:
Maybe this https://github.com/joric/nrfmicro/wiki/Bootloader#possible-issues

drakumus, 2022-08-26:
I went through those before posting:
The device can be connected overUART so that rules out the pull up resistor.
Windows doesn't recognize the device at all so the other issue referenced doesn't help me unfortunately. Their device just needed different USB drivers.

My running theory is the dfu flashed at address 0x800000 doesn't work for my board.

drakumus, 2022-08-29:
I bought another set of bluepills. This set matches the images on the troubleshooting page.
Checked the resistor value and it is the correct 10k.
Connected to the device over UART and realized something:
On both boards, iteration doesn't matter, it only detects 32kb of flash.
It looks like a minimum of 64kb is required for blackmagic probe.

drakumus, 2022-08-29:
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
A side by side of the 2 versions of blue pill, left one is the first set I bought, right one is the second set

I just noticed the component that has 32k written on it as well. Checking the aliexpress link you gave the first offering of blue pill on aliexpress also has that 32k:
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

drakumus, 2022-08-29:
Ok the issue is clear now.
The blue pills I bought off amazon (both types) use the cheaper STM32F103G6T6A (32kb flash)
The aliexpress blue pills use STM32F103C8T6 (64kb flash)

I guess let this be a warning that there are blue pills with smaller flash.

Closed 2022-08-29.

Thread 62 (2022-11-23):

Why not use the chip internal DCDC regulator?

cirias, 2022-11-23:
Hi Joric,

The current design uses an external LDO for the power supply.
I wonder if it's possible to use the internal DC/DC regulator for converting USB or battery voltage to 3.3V?

That will need an additional 10uh inductor between DCCH and VDD. Is there any specific reason you didn't do that?

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

joric, 2022-11-23:
there's nRFMicro 1.2, see wiki.

Closed 2022-11-23.

Thread 63 (2023-01-06):

Battery drops too fast

shaohao, 2023-01-06:
Hi,
I socketed 2 nrfmicro v1.4 to a split keyboard, and bonded it to two PC with BLE.
I found it takes half day (about 12 hours) for the battery (central)  to drop from 100% to 26%.
Does it drop too fast? I used the zmk power-profiler demo and it told me that the central side will takes 2weeks and 6days

Here is my configuration:
* nrfmicro v1.4 2pcs for split keyboard
* zmk
* sofle split keyboard v2
* bonded ble profiler: 2
* battery: Left: Li-po 61230 200mAh 3.7V, Right:  Li-po 801280 300mAh 3.7V

joric, 2023-01-07:
Does it have RGB LEDs? They draw 1mA each when off, you have to disable power pin with CONFIG_ZMK_RGB_UNDERGLOW_EXT_POWER=y. I don't know otherwise, must be software issue. Schematic leaks 10-55 uA depending on LDO.

Closed 2023-01-07.

Thread 64 (2023-01-29):

Missing capacitors on voltage regulator?

levpopov, 2023-01-29:
AP2112 LDO datasheet[1] specifies 1uF capacitors on VIN and VOUT but these are missing in the nrfmicro schematic. Is this intentional?

[1] https://www.diodes.com/assets/Datasheets/AP2112.pdf

PS thank you for this repo, it's a great resource.

joric, 2023-01-30:
No space, also we have a bunch on the module, it's in the FAQ. If you have space use 10uF before and 4.7uF after.

levpopov, 2023-01-30:
Ah, thanks for explaining

Closed 2023-01-30.

Thread 65 (2023-04-05):

Need guidance for JLC assembly: missing BOM & CPL files

buitrung, 2023-04-05:
First, thanks for your work on this awesome project!

I'm planning to order the board from JLC and also get assembled by them, because I may not be able to solder all the tiny parts together.
In the step to upload BOM & CPL .csv files, I don't have them.
From your ibom.html, I can extract the list of parts, but I don't find the positions of each part.

Can you show me how to get the desired files?
Here is an example of .csv files that I have successfully uploaded to JLC to get assembly in the past:
https://github.com/JeremyBois/Ogen/blob/main/PCB/data/production/V1.2/bom.csv
https://github.com/JeremyBois/Ogen/blob/main/PCB/data/production/V1.2/positions.csv

joric, 2023-04-07:
You probably won't be able to build this automatically. Placeholder tolerances are broken.

Closed 2023-04-07.

Thread 66 (2023-08-03):

I'm beaten after frying 3 boards

klesh, 2023-08-03:
Hi, Joric, I'm amazed by your work, but building a development board is intimidating for me.
So I went and bought 4 boards from Taobao and somehow I managed to break 3 out of them 🥲....
What is done is done, but not knowing why is the thing that bugs me..😂.
I'm desperate for answers...and yet, google didn't tell me nothing, here is the only one guy that seems to be having the same problem https://devzone.nordicsemi.com/f/nordic-q-a/71117/nrf52832-gpio-irreversible-pin-damage-in-application-when-used-as-a-momentary-switch-sense-input

**I'm wondering if you could give me some pointers, **
I'm trying to build a Ferris/Sweep using ZMK direct pin mod, The left part is done and seemed to be working fine while the right part... not so lucky.💔
Here are the 3 broken ones so far...
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
I soldered the 2 on the right and found out each of them has 1 pin always grounded (actually 2, another one I never used also shorted ).
So, I bought another one on the left and flashed the firmware, and used a tweezer to test the pins, it worked at first, and then again, it broke as well 😭...It seems like if the pin gets grounded too well for too long, it damage for good...

It would be great if you could take a look at my situation and suggest what I did wrong. 🙏
Thanks.

joric, 2023-08-04:
idk man. is it completely dead or just a few pins? when mcu burns it usually shorts vcc to ground

klesh, 2023-08-04:
@joric Thanks for the reply, it was a few pins.
I think it might be caused by testing the pin with a tweezer while the USB cable is connected.
I tried to solder a brand-new one without testing it, and it worked...

Closed 2023-08-05.

Thread 67 (2023-09-06):

Some tips

madushan1000, 2023-09-06:
I recently built a couple of nrfmicros. I'll share some tips someone else might find useful.

I used a cheap [hot air gun](https://www.aliexpress.com/item/1005005361520590.html)(25EUR) and [low melt solder paste](https://www.aliexpress.com/item/1005003245076474.html). It was really easy than trying to use an iron.

For the socket, I used [these](https://www.aliexpress.com/item/32869787942.html) (24 pin wide version) works okay, will have to cut off some plastic when I attach a battery though. They're a lot cheaper than anything else I could find.

For flashing the bootloader, you can also use a rapberrypi pico with picoprobe firmware. This command line will work on ubuntu. `openocd -d2 -f interface/cmsis-dap.cfg -f target/nrf52.cfg -s tcl` and then follow the guide in the wiki.

Closed 2023-09-10.

Thread 68 (2023-10-25):

How to check soldering for older versions?

ntrp, 2023-10-25:
Hello, thanks for this amazing project! I am having some issues with my board, probably due to bad soldering..

I have seen the https://github.com/joric/nrfmicro/wiki/Soldering#testing article but I have currently a older version (I think 0.03) which I built just now after ordering the pcbs some time ago. I tried the Diode testing mode between GND and any other pads but nothing happens, only activates when I touch the probes together.

Also I am using BMP over a BluePill and I can see this in the output after a `swdp_scan`:
```
(gdb) mon swdp_scan
Target voltage: unknown
Available Targets:
No. Att Driver
 1      Nordic nRF52 Access Port
```
Which looks wrong because I have seen other screenshots showing also a line saying `Nordic nRF52 M3/M4` and not only access port. Does that mean that my chip is badly soldered?

joric, 2023-10-25:
Tester should be set to diode mode not continuity mode. You measure voltage drop, not resistance.

ntrp, 2023-10-25:
Ok sorry.. stupid me, I switched the multimeter wheel to the right position but did not activate diode mode.. Also I was using the second pin, instead of the 3rd for GND, should doublecheck better next time..

I was trying to unlock using a BMP connected to SWC/SWD but when running the unlock code I was getting timeouts.

What about the bottom pins? How should I verify they are in order? If all gpio pins have 0,7 vdrop they are ok?

p.s. I found 2 GPIO pins which are not connected so now I need to figure out which connection needs a touch up..

Closed 2023-10-25.

Thread 69 (2023-11-19):

SuperMini NRF52840 and 52840nano

dudicoco, 2023-11-19:
Currently, the wiki states the SuperMini NRF52840 and 52840nano as the cheapest most readily available mass produced pro-micro compatible MCUs.
It would be helpful if there was a comparison between the two or if it is stated which one is recommended to get.

Thanks

joric, 2023-11-21:
Well it's there with all the issues, it should be pretty obvious that Supermini sucks less. https://github.com/joric/nrfmicro/wiki/Alternatives#supermini-nrf52840

dudicoco, 2023-11-21:
Seems like I missed this part https://github.com/joric/nrfmicro/wiki/Alternatives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.

Thanks!

Closed 2023-11-21.

Thread 70 (2023-11-28):

SuperMini NRF52840 AIN2 Battery

petanque, 2023-11-28:
With SuperMini NRF52840, is AIN2 connected as it is on Nice!Nano so battery volts can be measured?
In my experiments, the values   do not change and have therefore come to doubt whether it is possible.

joric, 2023-12-02:
Why AIN2? NIN2 measures voltage on VDDH it has nothing to do with AIN2.

Thread 71 (2023-11-29):

SK6812 LEDs power over USB and charging

NickHu, 2023-11-29:
Hi, thanks for making this. I saw in your wiki there are some pictures of you having this working with SK6812 LEDs. I believe they are supposed to be driven off ~5V input (according to https://cdn-shop.adafruit.com/product-files/4960/4960_SK6812MINI-E_REV02_EN.pdf), but the VCC on the nrfmicro is 3.3V. Could I please ask how you did the wiring?

My first thought was that you could attach a 5V boost converter to VCC, but I think you would also need a level shifter for the data line. I'm also a bit unsure as to whether or not an acceptable way to turn off the boost converter would be to just cut VCC, which I think nrfmicro is designed to do in sleep mode.

I guess it's probably a bad idea to try to power all these LEDs off the nrfmicro anyway, so if you were to use an external power bus you would need a boost converter from the B+/- terminals to 5V, but then you probably need a transistor to switch between battery/VBUS power depending on whether or it's plugged in to USB.

But then there's also current to think about. With 30 LEDs, that's a max draw of something like 1500mA which far exceeds what you can draw from USB (5V 500mA). I think I am arriving at the conclusion that this board is not designed to power LEDs in any way, and if I want that I need to power them by battery - but is it safe to have the battery charging via USB and discharging to the LEDs simultaneously? Having load on the battery might prevent the charger from thinking that the battery is charged and negate the overcharge protection.

joric, 2023-12-02:
USB usually support well over 500mA, it's not a real limitation.

Closed 2023-12-02.

Thread 72 (2023-12-03):

jlc and pcba

Franck78, 2023-12-03:
Hello Joris,

You have a greatly detailed page about one pcba experience with jlc (sure you have others) ;)

https://user-images.githubusercontent.com/852547/134808800-bf64651f-5538-4cc8-bfc9-b624481af0e0.png

At this time (2021), weigh calculator was pretty accurate. (24gr / 5 pcbs) or 80gr 30 pcbs

Not in 2023 it's another story !

I rechecked 2 identical previous order (no change).
One inflated by 200gr
The other, by 1Kg !!!!!

Just for info if you happen to reorder. Just check (or compare same board with / without pcba).

For the +1Kg board, it removes the cheap carrier (GDSL).

Closed 2023-12-03.

Thread 73 (2023-12-15):

Really low battery life

madushan1000, 2023-12-15:
I'm using two nrfmicro controllers in [this](https://github.com/strayer/taira-keyboard) split keyboard. [This is my zmk config](https://github.com/madushan1000/taira-keyboard-zmk-config). The keyboards does not have any power draining things like RGB/displays, but the battery life is really low, about 3 days with 80mah 301230 lipo battery.

Is this normal? any tips on how to improve it? Thank you :)

madushan1000, 2023-12-15:
I also noticed now that there is about 20% battery drain overnight if I forget to turn off the keyboard even though the deep seep timeout is set to 15 mins.

joric, 2023-12-15:
idk man. shouldn't be like this. try ZMK discord

madushan1000, 2023-12-16:
thanks, I will try that :)

madushan1000, 2023-12-16:
Just in case someone come across this. Turns out, my <keyboard>.conf file was in the wrong path and never got included(file has to be directly under config/). so probably sleep/idle modes never got enabled. Fixed it and waiting to see how the battery life is now.

Closed 2023-12-15.

Thread 74 (2024-02-29):

Compatibility with IBM model M

IronLover64, 2024-02-29:
Hi, I want to use your circuit to control an IBM model M keyboard and I need to use all the available 28 GPIOs on the board as 24 will be used to control the keyboard and the other 4 for the indicator lights (num lock, caps lock, scroll lock). Will I run into any issues or make any compromises doing this? I remember reading that you can desolder the P0.00 and P0.01 crystal to use as a free pin, but would doing so essentially disable the bluetooth function? I am also wondering if it's not possible to use the P0.12 pin or any of the low frequency for one of the rows/columns . Thanks for reading.

joric, 2024-03-08:
Crystal is not needed, all pins are listed in pinout article. At least 28 pins (including xtal pins) should be available.

joric, 2024-03-10:
@IronLover64 https://github.com/joric/nrfmicro/wiki/Components#crystal

Closed 2024-03-08.

Thread 75 (2024-06-01):

[Question] Pro Micro NRF52840 LED charging behaviour.

Finnitio, 2024-06-01:
Hey, could not find any other resources. Does anybody know the charging behaviour of the LED? It goes from solid to blinking, to off I think. But I do not know what that means? I also do not know why zmk gives 0 % charge over bluetooth but the keyboard still works for many days till the circuit shuts the battery off.

joric, 2024-06-02:
It doesn't go to blinking it's just on when charging and off when it's done. It blinks only if there's no battery. Measuring charging by voltage is often innacurate, last time I tried battery shuts off at 2.4V and ZMK may consider that below 0%. See https://github.com/joric/nrfmicro/wiki/Batteries about batteries.

Finnitio, 2024-10-14:
Anothe question, i noticed that when i try to charge my left side the whole keyboard does not work anymore. But for the right side it does noch affect the behaviour at all?

joric, 2024-10-14:
Separate halves should charge just fine, it should not affect the wireless link.

Closed 2024-06-02.

Thread 76 (2024-11-13):

DFU in SuperMini

meekowai, 2024-11-13:
How do you enter DFU in SuperMini? shorting gnd to rst once or twice is not doing it. I read a drive in windows is supposed to pop up. Thanks.

gretel, 2024-11-13:
> How do you enter DFU in SuperMini? shorting gnd to rst once or twice is not doing it. I read a drive in windows is supposed to pop up. Thanks.

have a look at https://github.com/joric/nrfmicro/wiki/Bootloader

meekowai, 2024-11-13:
So i guess I have bad board. Blue led is blinking twice as fast as the red one. No constant light, even after shorting gnd to rst. Can connect to the board via BT from nRF Connect on iOS though.
I might need to try RaspberryPI route. Will it work or are the boards trash?

meekowai, 2024-11-14:
Was able to revive one board with RPi.
The only question I have is which bootloader should I really use?
Supermini nrf52840 says to be nice!nano clone, has the same pins on pcb. Logic says I should use nince!nano bootloader from adafruit (which worked in my case and allowed me to flash Meshtastic) but maybe it doesn't matter and I can use generic pca10056 or nfrmicro?
Sorry for dumb question but is bootloader, apart from everything else, responsible also for which pins are exposed? I understand Meshtastic has different variants of boards and now I wonder if good working order depends on bootloader/firmware combo or just pins assigned in the meshtastic firmware.
Thanks.

joric, 2024-11-14:
Defective board. Double reset should work.

Closed 2024-11-14.

Thread 79 (2025-04-22):

Power consumption

dakhnod, 2025-04-22:
Heyo, I am the developer of [BLEnky](https://github.com/dakhnod/BLEnky), and wanted to thank you for your collection.

With the SuperMini you are writing about a quiescent current of 20uA.
Could you give me a hint on what pin and mode that is in? System Off?

In System On mode I can not get below 70uA or something.
Also, do you know that the difference between the B+/RAW and VCC pins is?

Cheers and thanks,
Daniel

joric, 2025-04-22:
VCC is a 3.3V output. RAW/B+ is 4.2V input and charging. They are totally separate circuits. Please read the wiki already no matter how I'm trying to coverl all that on the FRONT PAGE someone always writes first and reads later.

Supermini is an exact nicenano v2 clone and all pins are the same. Internal pin P0.13 is VCC control. Setting it to GND cuts off VCC.

Current was tested (not by me) and it was reported as 20uA. Some Superminis have 10M pullups some 500k. There's no real difference 20 uA or 70 uA you get 1000x more when the radio kicks in,

Closed 2025-04-22.

Thread 80 (2025-04-28):

ProMicro battery readings

richonguzman, 2025-04-28:
Hi,

don't know where to ask this but your repository helped me a lot to start.

I have ProMicro NRF52840 successfully advertising and using 700uA when coding on Platformio/VSCODE.

should i expect lower values with this board disabling parts of the board and such?

On the battery Readings, Pin 4 (AIN02) does not read real value on mine when not powered by usb), what should i check?

joric, 2025-04-28:
700uA spikes is OK for radio I guess, even 1-1.5 mA is fine. As for AIN02 I don't think it's connected to anything on nicenano clones. You just read internal VDDH voltage, refer to ZMK. I don't think there's a way to read battery voltage when USB is plugged in.

richonguzman, 2025-04-28:
thanks for the info,

so the multi tester is showing the 700uA spikes when BLE advertising! interesting!

AIN02 (pin4) does not show me any battery voltage readings running it without usb connected. Besides classic pin initiation should i declare any specifics to make it read the battery voltage?

joric, 2025-04-29:
I just said it's not connected to anything.

Closed 2025-04-28.

Thread 81 (2025-08-11):

Issues with Pro Micro nRF52840

duckida, 2025-08-11:
Hi @joric, you seem to be an expert on these boards!

I recently purchased a few of the ProMicro boards from your Alternatives section. However, I can’t really get them to work.

When flashed with CircuitPython, they work fine however when I try to start BLE it crashes and gives ‘Errno 6 Device not Configured’.

From the nRF Connect SDK (Zephyr) using the board `promicro_nrf52840` I can’t get it to show up in BLE, get serial console or anything.

I know there’s not a hardware issue because if I use the Jorde UF2 file from your Wiki the board shows up as a BLE keyboard on my phone.

From the Arduino IDE I can’t even manage to flash the code to the board - I double-click reset to get the NICENANO drive, but then the issue is:

```
Upgrading target on /dev/cu.usbmodem14101 with DFU package /private/var/folders/5z/f0cdk8091dn5ys0_j01m81240000gn/T/arduino_build_267356/glowdim-arduino-ble.ino.zip. Flow control is disabled, Single bank, Touch disabled

Failed to upgrade target. Error is: read failed: [Errno 6] Device not configured
Traceback (most recent call last):
  File "serial/serialposix.py", line 575, in read
OSError: [Errno 6] Device not configured

During handling of the above exception, another exception occurred:

Traceback (most recent call last):
  File "__main__.py", line 296, in serial
  File "dfu/dfu.py", line 235, in dfu_send_images
  File "dfu/dfu.py", line 203, in _dfu_send_image
  File "dfu/dfu_transport_serial.py", line 155, in send_init_packet
  File "dfu/dfu_transport_serial.py", line 243, in send_packet
  File "dfu/dfu_transport_serial.py", line 264, in get_ack_nr
  File "serial/serialposix.py", line 581, in read
serial.serialutil.SerialException: read failed: [Errno 6] Device not configured

Possible causes:
- Selected Bootloader version does not match the one on Bluefruit device.
    Please upgrade the Bootloader or select correct version in Tools->Bootloader.
- Baud rate must be 115200, Flow control must be off.
- Target is not in DFU mode. Ground DFU pin and RESET and release both to enter DFU mode.
```

If anyone has any ideas I would be very grateful! Thank you!

duckida, 2025-08-11:
Never mind, I solved the issue by following the Arduino guide from the `Bluemicro` section of your Wiki! It turned out I just had to use NRF52840 DK instead of Pro Micro board in Arduino IDE, then flashing worked!
