joric/nrfmicro/(commit log)

2019-02-23 second commit
    [nrfmicro.kicad_pcb, nrfmicro.sch]
2019-02-23 fixed outline
    [nrfmicro.kicad_pcb]
2019-02-23 pushed to version 0.2
    [nrfmicro.kicad_pcb, nrfmicro.sch]
2019-02-23 updated unsaved files
    [nrfmicro.kicad_pcb]
2019-02-23 fixed silkscreen
    [nrfmicro.kicad_pcb]
2019-02-23 fixed solder mask clearance
    [nrfmicro.kicad_pcb]
2019-02-23 fixed silk
    [nrfmicro.kicad_pcb]
2019-02-24 fixed SWDCLK typo, fully autorouted and optimized
    [nrfmicro.kicad_pcb, nrfmicro.sch]
2019-04-03 moved to hardware folder
    [nrfmicro.kicad_pcb, nrfmicro.sch]
2019-04-10 fixed Type-C and holes, pushed to version 0.02
    [nrfmicro.kicad_pcb, nrfmicro.sch]
2019-04-19 merged with reversible branch, pushed to version 0.03
    [nrfmicro.kicad_pcb, nrfmicro.sch]
2019-04-19 fixed charger stat
    [nrfmicro.kicad_pcb, nrfmicro.sch]
2019-04-19 fixed pinout and schematic, added SWD header
    [nrfmicro.kicad_pcb, nrfmicro.sch]
2019-04-19 fixed D1 value from 1N5817 (SMA) to 1N5819 (SOD-123)
    [nrfmicro.sch]
2019-04-19 better placement
    [nrfmicro.kicad_pcb]
2019-05-11 updated schematics
    [nrfmicro.kicad_pcb, nrfmicro.sch]
2019-05-12 fixed schematic
    [nrfmicro.kicad_pcb, nrfmicro.sch]
2019-05-14 updated placement
    [nrfmicro.kicad_pcb, nrfmicro.sch]
2019-05-14 test autoroute in TopoR, updated readme
    [nrfmicro.kicad_pcb]
2019-05-14 autorouted, moved a bit by hand
    [nrfmicro.kicad_pcb]
2019-05-17 autorouted with freerouting
    [nrfmicro.kicad_pcb]
2019-05-17 fixed silk and caps
    [nrfmicro.kicad_pcb, nrfmicro.sch]
2019-05-17 fixed layout, added gerbers
    [nrfmicro.kicad_pcb]
2019-05-17 fixed layout
    [nrfmicro.kicad_pcb, nrfmicro.sch]
2020-01-16 updated files
    [nrfmicro.kicad_pcb]
2020-01-25 new usb-c footprint
    [nrfmicro.kicad_pcb, nrfmicro.sch]
2020-02-09 new usb footprints, switch pin moved from 0.26 to 0.04
    [nrfmicro.kicad_pcb, nrfmicro.sch]
2020-02-27 pushed to version 1.0
    [nrfmicro.sch]
2020-02-27 version 1.1
    [nrfmicro.kicad_pcb, nrfmicro.sch]
2020-02-27 reverted microusb footprint, better vias
    [nrfmicro.kicad_pcb, nrfmicro.sch]
2020-02-27 added 1.1 gerbers
2020-03-01 added silk
    [nrfmicro.kicad_pcb]
2020-03-11 added gerbers
2020-03-13 VDDH passthrough (VCC is limited to 25 ma)
    [nrfmicro.kicad_pcb, nrfmicro.sch]
2020-03-13 version 1.2, autorouted
    [nrfmicro.kicad_pcb, nrfmicro.sch]
2020-04-24 fixed vias
    [nrfmicro.kicad_pcb]
2020-04-24 removed gerbers
2020-04-24 fixed 3d model
    [nrfmicro.kicad_pcb]
2020-04-26 ext_vcc version
    [nrfmicro.kicad_pcb, nrfmicro.sch]
2020-04-26 fixed tolerances
    [nrfmicro.kicad_pcb]
2020-04-27 added new E73-2G4M08S1C model
    [nrfmicro.kicad_pcb]
2020-04-28 fixed power circuit
    [nrfmicro.kicad_pcb, nrfmicro.sch]
2020-04-28 new silk
    [nrfmicro.kicad_pcb, nrfmicro.sch]
2020-05-03 jumper closed by default
    [nrfmicro.kicad_pcb, nrfmicro.sch]
2020-05-09 nrfmicro 1.2 with 73811 and 2112K as EXT_CC
    [nrfmicro.kicad_pcb, nrfmicro.sch]
2020-05-09 cosmetic fixes
    [nrfmicro.kicad_pcb, nrfmicro.sch]
2020-05-09 small fixes
    [nrfmicro.kicad_pcb, nrfmicro.sch]
2020-05-09 nrfmicro 1.2 alpha
    [nrfmicro.kicad_pcb, nrfmicro.sch]
2020-05-13 added reverse schottky, no LED ballast, warning!
    [nrfmicro.kicad_pcb, nrfmicro.sch]
2020-05-13 back to unfiltered RAW on EXT_VCC, autorouted
    [nrfmicro.kicad_pcb, nrfmicro.sch]
2020-05-13 nrfmicro 1.2 beta
    [nrfmicro.kicad_pcb]
2020-05-13 nrfmicro 1.2 beta with analog PROG
    [nrfmicro.kicad_pcb, nrfmicro.sch]
2020-05-13 nrfmicro 1.2 beta, cosmetic changes
    [nrfmicro.kicad_pcb]
2020-05-14 nrfmicro 1.2 beta, DRC check
    [nrfmicro.kicad_pcb]
2020-05-14 nrfmicro 1.2 beta, leave space for jlcpcb branding
    [nrfmicro.kicad_pcb]
2020-05-16 nrfmicro 1.3 take one. autorouted
    [nrfmicro.kicad_pcb, nrfmicro.sch]
2020-05-16 nrfmicro 1.3 take two. autorouted
    [nrfmicro.kicad_pcb, nrfmicro.sch]
2020-05-16 nrfmicro 1.3 take three, autorouted
    [nrfmicro.kicad_pcb]
2020-05-16 nrfmicro 1.3 take 4, autorouted
    [nrfmicro.kicad_pcb, nrfmicro.sch]
2020-05-16 minor changes
    [nrfmicro.kicad_pcb]
2020-05-16 nrfmicro 1.3 pre-release, autorouted
    [nrfmicro.kicad_pcb]
2020-05-16 headers moved 0.1+0.1 mm apart
    [nrfmicro.kicad_pcb]
2020-05-16 0.2mm usb-c pad clearance
    [nrfmicro.kicad_pcb]
2020-05-16 custom silk
    [nrfmicro.kicad_pcb]
2020-05-18 better traces
    [nrfmicro.kicad_pcb, nrfmicro.sch]
2020-05-28 new schematic, 0.15 traces
    [nrfmicro.kicad_pcb, nrfmicro.sch]
2020-05-29 autorouted with power classes 0.15/0.2
    [nrfmicro.kicad_pcb, nrfmicro.sch]
2020-06-10 went 0.2 tolerances everywhere
    [nrfmicro.kicad_pcb, nrfmicro.sch]
2020-06-11 better silk
    [nrfmicro.kicad_pcb]
2020-09-30 Update to V1.4
    List of changes:
    - USB connector shifted up to allow for another row of 0603 devices.
    - Prog pin to ground again
    - Red charging LED and resistor added again
    - Capacitor between 3v3 regulator after schottky diode and ground added
    - 2M pulldown resistor to ground for VCC transistor added so 1.09 doesn't have to be initialized anymore.
    - Full SWD and USB breakouts added.
    [nrfmicro-B_Cu.gbl, nrfmicro-B_Mask.gbs, nrfmicro-B_Paste.gbp, nrfmicro-B_SilkS.gbo, nrfmicro-Edge_Cuts.gm1, nrfmicro-F_Cu.gtl, nrfmicro-F_Mask.gts, nrfmicro-F_Paste.gtp]
2020-10-02 Connected VDD and VDDH together
    As recommended by Nordic in when nRF52840 is in normal voltage mode
    [nrfmicro-B_Cu.gbl, nrfmicro-B_Mask.gbs, nrfmicro-B_Paste.gbp, nrfmicro-B_SilkS.gbo, nrfmicro-Edge_Cuts.gm1, nrfmicro-F_Cu.gtl, nrfmicro-F_Mask.gts, nrfmicro-F_Paste.gtp]
2020-10-02 Joined VDD and VDDH
    As recommended by Nordic when using chip in normal voltage mode
    [nrfmicro-B_Cu.gbl, nrfmicro-B_Mask.gbs, nrfmicro-B_Paste.gbp, nrfmicro-B_SilkS.gbo, nrfmicro-Edge_Cuts.gm1, nrfmicro-F_Cu.gtl, nrfmicro-F_Mask.gts, nrfmicro-F_Paste.gtp]
2020-10-02 Connected VDD and VDDH
    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
    [nrfmicro-B_Cu.gbl, nrfmicro-B_Mask.gbs, nrfmicro-B_Paste.gbp, nrfmicro-B_SilkS.gbo, nrfmicro-Edge_Cuts.gm1, nrfmicro-F_Cu.gtl, nrfmicro-F_Mask.gts, nrfmicro-F_Paste.gtp]
2020-10-03 Removed uncompressed gerbers
    [nrfmicro-B_Cu.gbl, nrfmicro-B_Mask.gbs, nrfmicro-B_Paste.gbp, nrfmicro-B_SilkS.gbo, nrfmicro-Edge_Cuts.gm1, nrfmicro-F_Cu.gtl, nrfmicro-F_Mask.gts, nrfmicro-F_Paste.gtp]
2020-10-06 Added the cat back
    A moment of silence for the catmelon who was lost previously
    [nrfmicro.kicad_pcb]
2020-10-12 Added pcb.io compatibility, made X1 (Y1) easier to hand-solder, rerouted trace
    [nrfmicro.kicad_pcb, nrfmicro.sch]
2020-11-06 back to oval drills
    [nrfmicro.kicad_pcb]
2020-11-20 top oval drills moved 0.15mm down
    [nrfmicro.kicad_pcb]
2021-03-04 added f.paste for the usb connector mounting holes
    [nrfmicro.kicad_pcb]
2022-01-02 converted to kicad 6.0
    [nrfmicro.kicad_pcb, nrfmicro.kicad_sch, nrfmicro.sch]
2022-01-02 bumped to 1.4.x
    [nrfmicro.kicad_pcb]
2022-01-02 added 833 jumper
    [nrfmicro.kicad_pcb, nrfmicro.kicad_sch]
2022-01-02 fixed annotation
    [nrfmicro.kicad_pcb]
2022-01-03 fixed clearance
    [nrfmicro.kicad_pcb]
2023-01-16 fix bom
    [nrfmicro.kicad_pcb]
2023-01-17 RPROG set to 10K
    [nrfmicro.kicad_pcb]
2023-07-21 fix side pads (move closer to edge)
    [nrfmicro.kicad_pcb]
